TBRTK/avia-pole-mount-public/docs/CLEANUP_AUDIT.md

# Cleanup audit - 2026-10-17

Authenticated repository: **TBRTK/avia-pole-mount**, private, main `f36eeeb0b89c758d7f15fa709191d412e8e53ff8`. A complete local mirror, verified Git bundle and all 88 baseline files preserve the original privately.

Inspected: all **3 reachable commits, 97 unique blobs**, single main branch and nested contents/object graphs of all 3 FCStd archives. No tags, releases, PRs or LFS pointers were present in the snapshot. All original stills, poster, sampled GIF stages, source scripts and rights registers were reviewed. Paths, file types and STEP headers were inspected. Inaccessible/deleted objects, external clones/caches and files never uploaded are outside scope.

All three originals embed `Part__Feature` (sensor, 1,431 faces), `Part__Feature001` (connector, 134 faces), `Part__Feature002` (manufacturer FOV). V1.2 also has transformed `V12_SensorReference`, `V12_ConnectorReference`, `V12_FOVReference` and cached aggregates. These entered commit **746a85a**. No standalone Livox STEP/manual was committed. No separate supplier CAD/photo/catalogue PDF was found; hardware references are self-built simplified geometry.

| Baseline content | Public edition |
| --- | --- |
| Three mixed FCStd files | Three `*_Public.FCStd` copies with the same native user bracket constructions. Import nodes/origins/containers removed; transformed wrappers re-linked to independent references. |
| Three STL + three own STEP | Byte-identical, same paths. |
| Sensor / connector / FOV | Independent box with four bores, provisional cable cylinder and angular loft; no copied or sampled surfaces. |
| GUI records / thumbnails | Old records discarded; fresh views/thumbnails generated only from clean geometry. Old reference BREP member hashes checked absent. |
| Nine original media binaries | Private only; replaced publicly by clean views, RS4 Pro animation and separate concept illustration. |
| Historical scripts/evidence/reports/audit logs/preview/stale manifests | Preserved privately. Relevant assembly, hardware, printing and limitations text retained/updated; new public scripts/notices/checks supplied. |
| Embedded report/validation metadata and manual paths | Original reports remain private; public CAD metadata points to current verification/limitations and removes local machine paths. Geometry and native design controls are retained. |
| RS4 Pro | Independent hidden envelope at adjustable pole height. Official Pro STEP and detailed V1.2 model supplied as manufacturer reference geometry; Emlid rights excluded from TBRTK grants. Private backup retained. |
| Supplied RS4 STEP | Header identifies RS4, not Pro. Retained privately, no silent substitution. |
| Person/RPi image | AI concept, not a measured product installation. |

Initial cleanup comparisons show **0 mm³ symmetric geometric difference** for all three printable solids in each version; all are valid, closed single solids. No non-import original object was removed. Further checks: [VERIFICATION](VERIFICATION.md), [geometry report](geometry-checks.json).

References do not prove real fit, all clearances, strength, thread engagement, camera/radio visibility, calibration or RPi installation. Livox redistribution permission is absent. Emlid manufacturer content retains its separate source and rights notices. Original CAD licence/TBRTK attribution are retained and Emlid rights are separately identified. No destructive history rewrite, force push or visibility change is performed.
