TBRTK/avia-pole-mount-public/docs/PUBLICATION.md

# Public repository - 2026-10-17

The owner requested this separate public repository: [TBRTK/avia-pole-mount-public](https://github.com/TBRTK/avia-pole-mount-public).

It is initialized from the verified cleaned export with a new root commit and no old parents, tags, private branches, `.git` directory or source-history objects. It is not a fork. The original `TBRTK/avia-pole-mount` remains private with its original files and history preserved.

The first publication retained the reviewed package. The first prototype release translates project text, FreeCAD labels/notes and media captions to English and updates the complete-setup illustration. FreeCAD geometry members, six bracket STL/STEP exports and the Emlid Pro STEP remain unchanged. Livox manufacturer solids remain excluded. All original user-created bracket designs are retained. See the [prototype release notes](releases/v1.2.0-prototype.1.md).

Emlid CAD is supplied as manufacturer reference geometry. Emlid rights are excluded from TBRTK's CC/MIT grants. [Specific notice](../cad/vendor/emlid/README.md). Prototype/physical-validation limits continue to apply.

Never merge original private branches or push their tags into this public repository. See [history guidance](HISTORY_CLEANUP.md) and [publication metadata](publication.json).
