TBRTK/avia-pole-mount-public/docs/ROADMAP.md

# Remaining work

1. Measure trial prints and purchased hardware; check assembly, cone contact/reserves, tool access and actual sensor thread limits.
2. Test dummy-load grip, backlash, preload, hinge retention/wear, angle stability and warm creep before service.
3. Measure the actual pole-top mount/adapter, receiver camera/radio clearances, cables and complete system mass on upright and tilted poles.
4. Specify the RPi enclosure, attachment, power, thermal design and cabling; the concept illustration is not that design.
5. Establish measured GNSS/Avia lever-arm and alignment calibration.
6. Keep this new public history separate from the private original; do not merge old branches or push private tags. Retain Emlid source and copyright notices and select any broader documentation/media reuse licence separately.
