TBRTK/avia-pole-mount-public/docs/THIRD_PARTY.md

# Third-party register

| Material | Finding / action |
| --- | --- |
| Livox sensor, connector, FOV CAD | Embedded in all three original FCStd files. Imports and transformed/cached copies replaced publicly; original private files retained. No redistribution permission established. |
| Livox original STEP/manual | No standalone copy among audited Git blobs. Source documentation refers to them. Private or linked only. |
| Original presentation media | Six PNG views, poster PNG, GIF, MP4 retained privately. Manufacturer-model views excluded; clamp-only views also replaced rather than carrying undecided media licences. |
| Emlid STEP/drawing | Official Pro STEP and embedded V1.2 manufacturer reference model. Emlid rights remain separate from TBRTK licence grants. Drawing and separate RS4 STEP remain private. [Source and rights notice](../cad/vendor/emlid/README.md). |
| Livox website/download materials | [Livox terms, section 9](https://www.livoxtech.com/terms) reserve rights. Download availability is not treated as redistribution permission. |
| Hardware | Existing self-built simplified fasteners/pole/tool envelopes retained. No supplier catalogue artwork/photo/PDF or supplier CAD found. [Dimensional sources](HARDWARE.md) retained; supplier rights not granted. |
| User bracket | All native user designs retained; own print exports preserved. |
| Licence text/tools | Original CC legal text retained unchanged. FreeCAD/OCCT/Pillow used locally; no binaries or vendor source bundled. |

This is a provenance/file audit and publication boundary, not a finding that every factual number is protected or that any particular licence is legally required. No manufacturer endorsement or comprehensive patent/design-right clearance is claimed. Emlid content retains its separate rights.
