TBRTK/avia-pole-mount-public/assets/images/public-fov.png

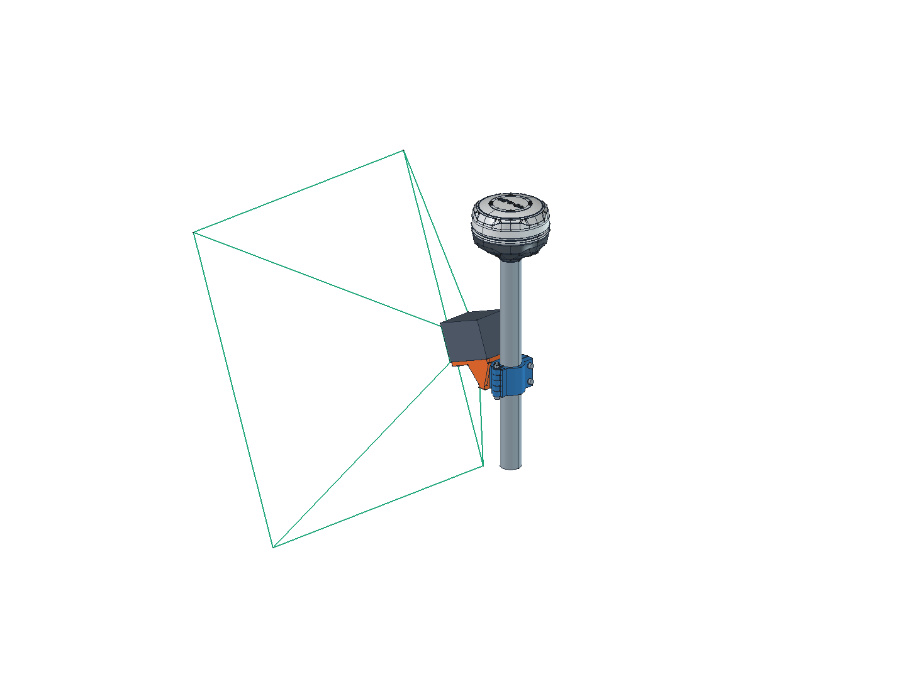
assets/images/public-fov.png
