TBRTK/avia-pole-mount-public/assets/images/rs4pro-official-render.png

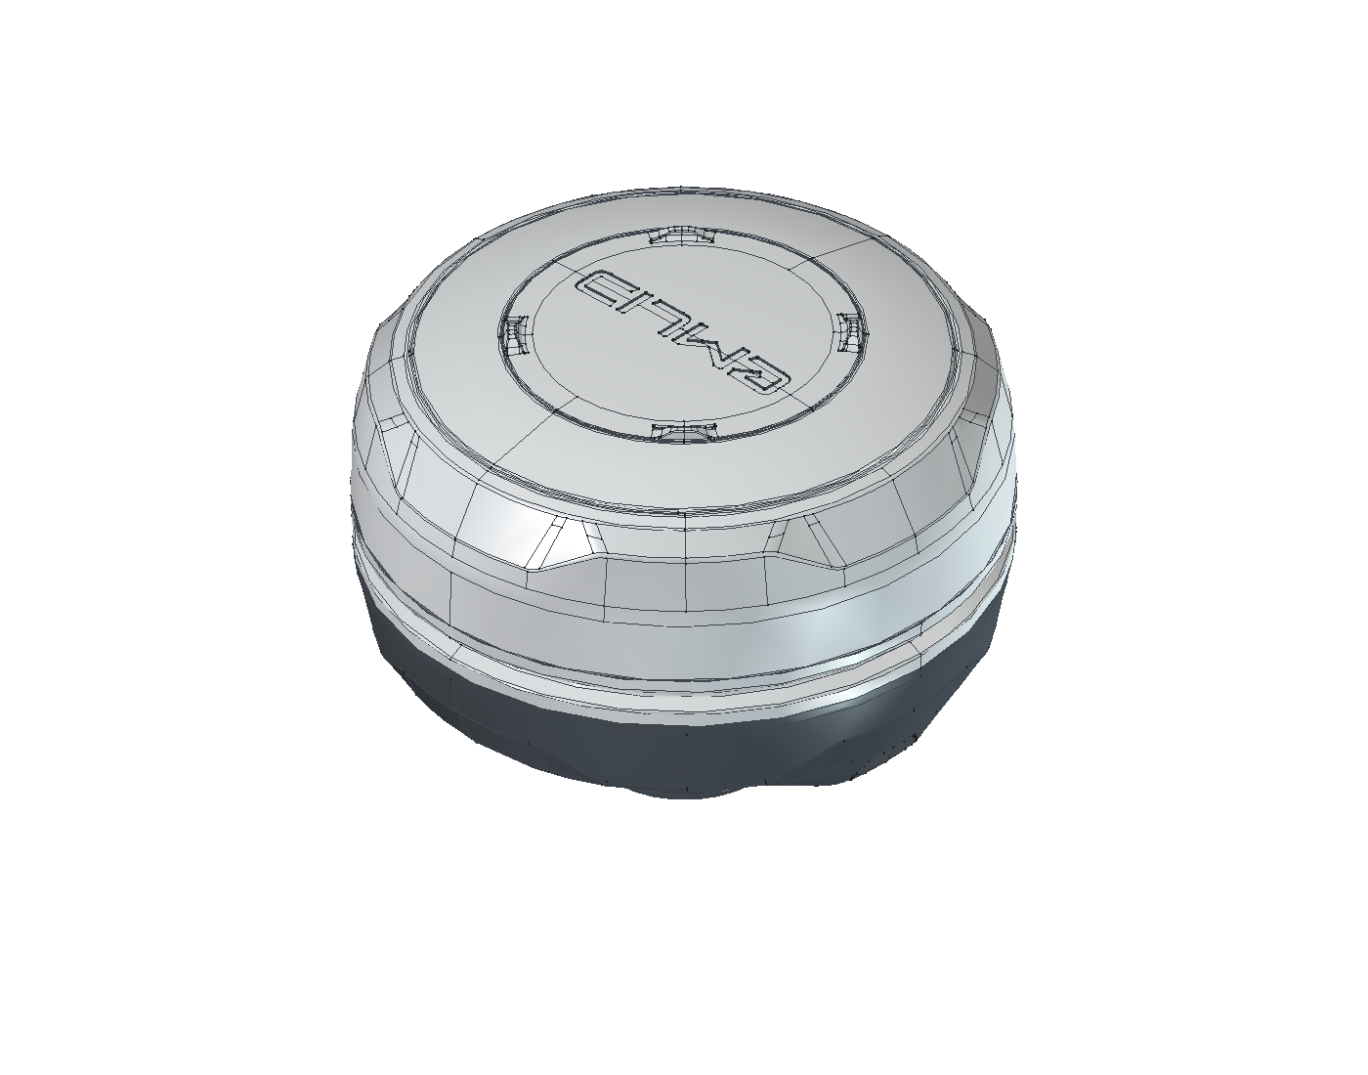
assets/images/rs4pro-official-render.png
