TBRTK/avia-pole-mount-public/cad/step/v1.2/Avia_35mm_V1.2_AviaBracket.step

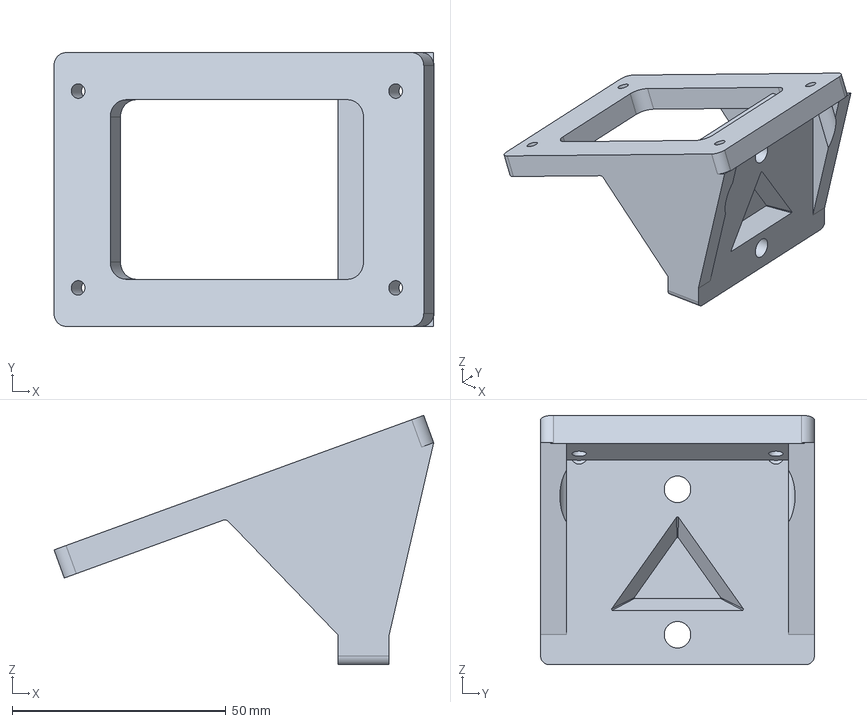
[picture p6: CAD file, 2026-10-17]
cad/step/v1.2/Avia_35mm_V1.2_AviaBracket.step
88.8 x 64.0 x 58.3 mm
