TBRTK/avia-pole-mount-public/cad/Avia_PoleMount_35mm_V1.2_Public.FCStd

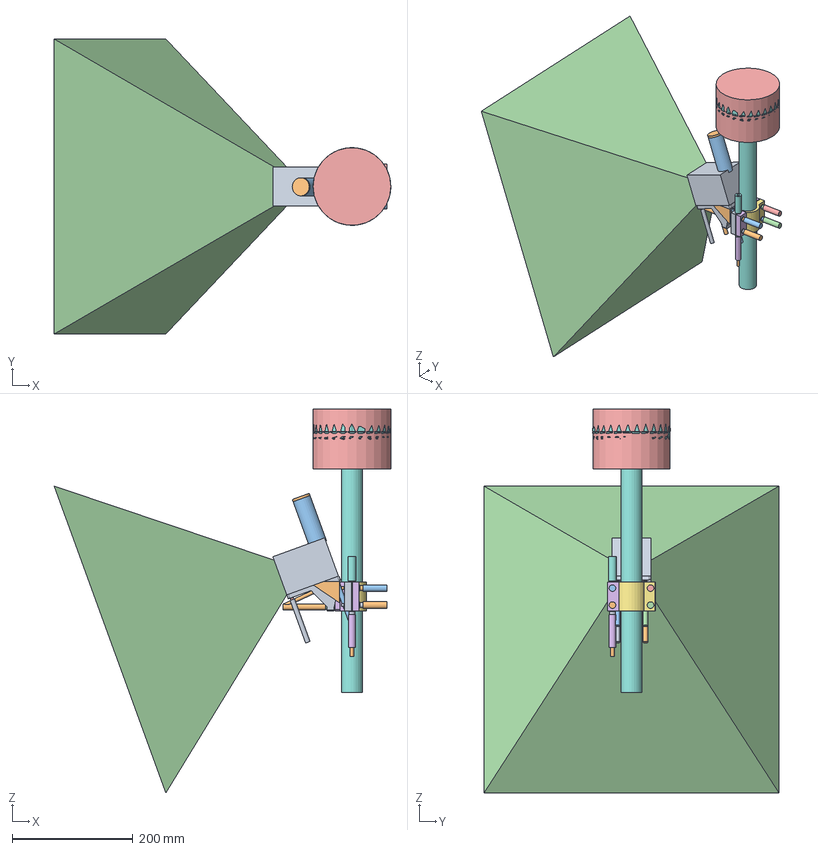
[picture p7: CAD file, 2026-10-17]
cad/Avia_PoleMount_35mm_V1.2_Public.FCStd
556.9 x 488.1 x 635.1 mm
03 Avia bracket
Clamp Driver Access1
Clamp Driver Access2
Clamp Driver Access3
Clamp Driver Access4
01 Front clamp
Clamp Front Nut Pocket1
Clamp Front Nut Pocket2
Clamp M5 Bolt1
Clamp M5 Bolt2
Clamp M5 Bolt3
Clamp M5 Bolt4
Clamp M5 Nut1
Clamp M5 Nut2
Clamp M5 Nut3
Clamp M5 Nut4
Clamp M5 Through1
Clamp M5 Through2
Clamp M5 Washer1
Clamp M5 Washer2
Clamp M5 Washer3
Clamp M5 Washer4
02 Rear clamp
Emlid Reach RS4 Pro - manufacturer reference geometry
Front Earm1
Joint Driver Access1
Joint Driver Access2
Joint M5 Bolt1
Joint M5 Bolt2
Joint M5 Nut1
Joint M5 Nut2
Joint M5 Washer1
Joint M5 Washer2
Left Reinforcement
Matching Key Socket
Positive Shear Key
RS4 Pro Reference
Rear Earm1
Right Reinforcement
Rod35 Reference
Survey Pole Stud Reference
V12 Cable Keepout
V12 Connector Reference
V12 FOVReference
V12 Hinge Bottom Thrust
V12 Hinge Head Driver
V12 Hinge Locknut
V12 Hinge Nut Socket Shell
V12 Hinge Pin
V12 Hinge Pin Insertion
V12 Hinge Retaining Washer
V12 Hinge Top Thrust
V12 M3 Bolt1
V12 M3 Bolt2
V12 M3 Bolt3
V12 M3 Bolt4
V12 M3 Driver1
V12 M3 Driver2
V12 M3 Driver3
V12 M3 Driver4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
