TBRTK/avia-pole-mount-public/cad/step/v1.2/Avia_35mm_V1.2_ClampRear.step

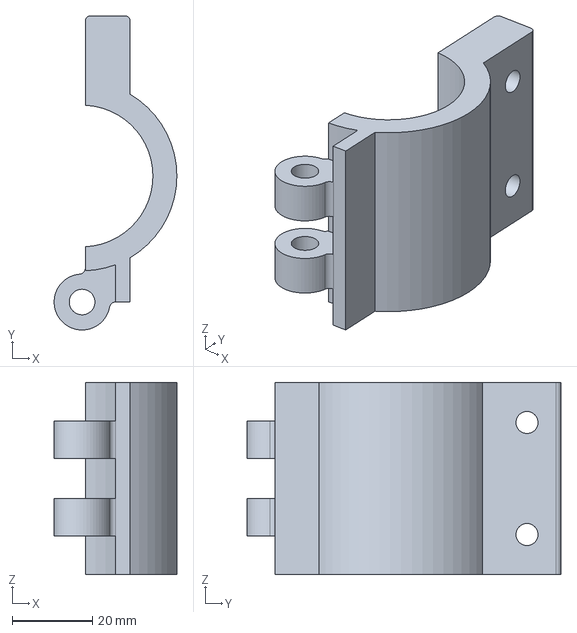
[picture p8: CAD file, 2026-10-17]
cad/step/v1.2/Avia_35mm_V1.2_ClampRear.step
30.7 x 78.5 x 48.0 mm
