TBRTK/avia-pole-mount-public/print/v1.2/Avia_35mm_V1.2_01_ClampFront_hinge.stl

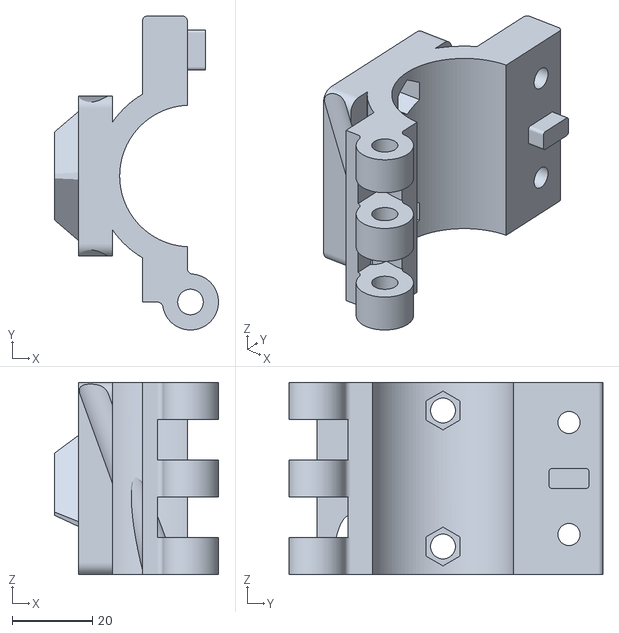
[picture p9: CAD file, 2026-10-17]
print/v1.2/Avia_35mm_V1.2_01_ClampFront_hinge.stl
41.0 x 78.5 x 48.0
