TBRTK/avia-pole-mount-public/cad/Avia_PoleMount_35mm_V1.0_Public.FCStd

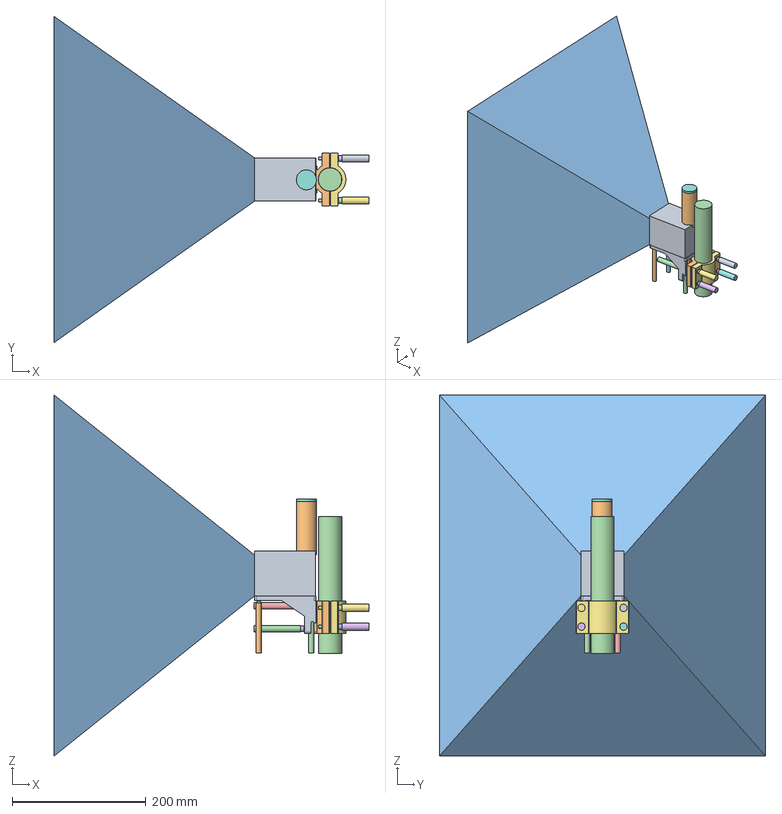
[picture p10: CAD file, 2026-10-17, an earlier design]
cad/Avia_PoleMount_35mm_V1.0_Public.FCStd
471.0 x 488.1 x 540.2 mm
03 Avia bracket
Avia Driver Access1
Avia Driver Access2
Avia Driver Access3
Avia Driver Access4
Avia M3 Bolt1
Avia M3 Bolt2
Avia M3 Bolt3
Avia M3 Bolt4
Avia M3 Washer1
Avia M3 Washer2
Avia M3 Washer3
Avia M3 Washer4
Clamp Driver Access1
Clamp Driver Access2
Clamp Driver Access3
Clamp Driver Access4
01 Front clamp
Clamp M5 Bolt1
Clamp M5 Bolt2
Clamp M5 Bolt3
Clamp M5 Bolt4
Clamp M5 Nut1
Clamp M5 Nut2
Clamp M5 Nut3
Clamp M5 Nut4
Clamp M5 Washer1
Clamp M5 Washer2
Clamp M5 Washer3
Clamp M5 Washer4
02 Rear clamp
Connector Cable Keepout
Independent Avia Envelope
Independent Connector Envelope
Independent FOVKeepout
Joint Driver Access1
Joint Driver Access2
Joint M5 Bolt1
Joint M5 Bolt2
Joint M5 Nut1
Joint M5 Nut2
Joint M5 Washer1
Joint M5 Washer2
Rod35 Reference
