TBRTK/avia-pole-mount-public/(list of files, cad)

Other CAD files:
print/v1.2/Avia_35mm_V1.2_03_AviaBracket_20deg.stl
cad/step/v1.2/Avia_35mm_V1.2_ClampFront.step
print/v1.2/Avia_35mm_V1.2_02_ClampRear_hinge.stl
