TBRTK/avia-pole-mount-public/print/v1.2/README.md

# V1.2 print files

Three unchanged user-created print parts, units mm, assembly coordinates retained:

1. [Front clamp](Avia_35mm_V1.2_01_ClampFront_hinge.stl)
2. [Rear clamp](Avia_35mm_V1.2_02_ClampRear_hinge.stl)
3. [20-degree bracket](Avia_35mm_V1.2_03_AviaBracket_20deg.stl)

No sensor, receiver, connector or FOV solids are included. RS4 Pro and pole display references are not new print parts.

[Printing](../../docs/PRINTING.md) · [hardware](../../docs/HARDWARE.md) · [verification](../../docs/VERIFICATION.md) · [CC BY-NC-SA 4.0 scope](../../LICENSE.md). Credit TBRTK. Prototype: physical validation pending.
