TBRTK/avia-pole-mount-public/CHANGELOG.md

# Changes

## v1.2.0-prototype.1 - 2026-10-17

- First public prototype release with a complete FreeCAD/STEP/STL ZIP, separate animation, complete-setup illustration and SHA256 checksums.
- English labels in the illustration, animation, FreeCAD object labels, parameter notes and CAD instructions.
- RPi enclosure below the gripping hand in the final selected illustration; Avia faces away from the person.
- Neutral Emlid source/copyright wording; manufacturer reference content retains its separate rights.
- Bracket geometry, existing STEP/STL print exports and Emlid source STEP are unchanged.

## Independent-reference edition - 2026-10-17

- Retained V1.0/V1.1/V1.2 native bracket designs and unchanged V1.2 STL/STEP print exports.
- Replaced embedded Livox sensor, connector, FOV and cached copies with independent parametric references.
- Added adjustable pole-top RS4 Pro envelope and official Pro CAD as manufacturer reference geometry; Emlid rights remain separate.
- Rebuilt views/animation and added a concept illustration with person and RPi enclosure.
- Updated attribution, licence scope, third-party register, verification and history-publication procedure.

The private upstream retains the original development history and mixed-content sources. This clean export does not rewrite it.
