TBRTK/avia-pole-mount-public/(commit log)

2026-10-17 Publish cleaned Avia pole mount with independent Livox references and approved RS4 Pro CAD
    [Avia_35mm_V1.2_01_ClampFront_hinge.stl, Avia_35mm_V1.2_02_ClampRear_hinge.stl, Avia_35mm_V1.2_03_AviaBracket_20deg.stl, Avia_35mm_V1.2_AviaBracket.step, Avia_35mm_V1.2_ClampFront.step, Avia_35mm_V1.2_ClampRear.step, Avia_PoleMount_35mm_V1.0_Public.FCStd, Avia_PoleMount_35mm_V1.1_Public.FCStd]
2026-10-17 Prepare first public prototype release with English media and CAD notes
    [Avia_PoleMount_35mm_V1.0_Public.FCStd, Avia_PoleMount_35mm_V1.1_Public.FCStd, Avia_PoleMount_35mm_V1.2_Public.FCStd]
2026-10-17 Link companion Raspberry Pi logger and planned web interface
